JuliaCJ/FlexType-EMG-Keyboard/README.md

Thank you for ckecking out the FlexType EMG Keyboard! Due to privacy laws, we cannot share our gesture dataset on GitHub.

To see our product in action, check out our video demo [here](https://youtu.be/fAkPNovlsvg).
