JuliaCJ/FlexType-EMG-Keyboard/Documentation/Project Proposal/Customer Interview Plan.docx

Customer Interview Plan

Assumptions:

1. The user has some or most upper arm/ wrist muscle function
2. The user cannot perform fine/ delicate motor functions
3. The user needs to perform tasks that require typing
4. The user wants privacy when communicating
5. The user desires autonomy for typing related tasks

Interview Questions (For Disabled Users):

- What is your experience typing on traditional computer and mobile keyboards?
- What alternative to traditional keyboards do you use, if any?
- Have you ever asked anybody for help with typing-related tasks, ex. sending a text?
- What qualities do you look for in keyboards?
- What types of hand/ wrist/ arm movement are easiest for disabled people? Hardest?
- What struggles do you have when operating traditional keyboards?
- What struggles do you have when operating alternative keyboards, ex. Voice to text?

Interview Questions (For Caretakers):

- What is your experience helping patients type on traditional computers and mobile keyboards?
- What alternative to traditional keyboards do you usually recommend, if any?
- Have you ever been tasked with performing typing related tasks for patients?
- What qualities of traditional keyboards are hurtful for disabled patients?
- What types of hand/ wrist/ arm movement are easiest for disabled people? Hardest?
- What struggles do you see your patients encounter when they operate traditional keyboards?
- What struggles do you see your patients encounter when they operate alternative keyboards?

Contact List:

Jalen:

- Lourdes, Caretaker
- Leslie, Caretaker
- Dennis, Veteran
- Dexter, Disabled
- Tila, Caretaker

Giancarlos:

- Alejandro, Disabled
- Nydia, Therapist
- Wilfredo, Caretaker
- Renjith, Caretaker
- Faye, Caretaker

Julia:

- Barry, Disabled
- Brien, Caretaker
- Fanta, Caretaker
- Shawn, Caretaker
- Alma, Caretaker

Kejon:

- Ernest, Caretaker
- Garyah Fumbah, Caretaker
- Tola, Caretaker
- Sarai, Caretaker
- David, Disabled

Industry Experts:

- Dr. Coskus Tekes
- Dylan Gaines
