JuliaCJ/FlexType-EMG-Keyboard/Documentation/Project Design/Milestone 3 Presentation and Demo.pptx

## FlexType EMG Keyboard


Half-Byte Solutions

Julia Johnson
Giancarlos Hernandez Mendoza
Jalen Tottress
Kejon IverY

## Project Introduction

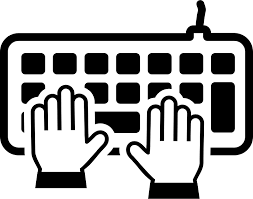
[picture p68: figure]
Typing Icon SVG Vector & PNG Free ...

- Problem Statement
  - A lot of people in the digital era uses a cellphone, laptop, or tablet daily to conduct daily activities. Yet for those who may not be able to do the same due to lack of fine muscle movement, there is nothing on the current market for this group of people. With that being said, what if there was a product to bridge the gap between fine motor limitation and digital autonomy.

- Our Solution
  - An electromyography keyboard that does not depend on fine motor movements
- Intended Users & Applications
  - Those who have limited fine motor control and want autonomy when engaging with the digital world

## Market Research

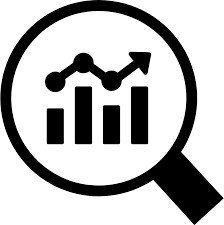
[picture p69: figure]
Market Research Analysis Icon SVG Vector & PNG Free Download | UXWing

- Target Users
  - Individuals with limited fine motor control
  - People who have difficulty using standard keyboards
- Existing Solutions
  - Voice-to-text
  - Wearable EMG devices (Meta Wristband)
  - Assistive input devices (Eye Tracking)
- Gaps
  - Voice inputs can lack privacy and reliability in noisy environments
  - Existing solutions can have steep learning curve, be expensive, or are too heavy to carry around

- How We're Different
  - The FlexType EMG Keyboard utilizes the user's muscle signals via a range of gestures to type words, with the help of a word prediction model
  - Designed with low-effort movements to support our target audience.
  - We are more private and discreet than voice-based systems
  - Cheaper than most existing solutions

## Product Requirements

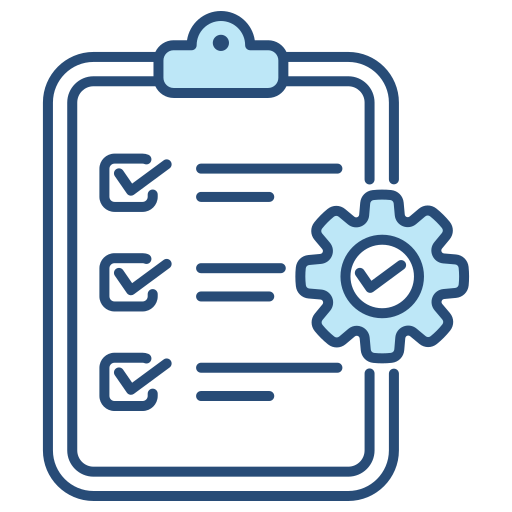
[picture p70: figure]
Requirement - Free files and folders icons

- Top Functional Requirements
  - EMG Wristband shall operate in low-power mode when not actively used
  - EMG wristband that converts analog EMG signal to digital
  - Wearable Device that transmits data
- Key Performance Targets
  - Gesture classification of 90% accuracy and above
  - Word Prediction of 90% accuracy and above
  - The EMG Wristband shall "wakeup" within 5 seconds of activation gesture

- Constraints & Assumptions
  - An economic constraint would be which EMG sensor to use, we opted to use 2-channel instead of 8 since the cost would be significantly cheaper
  - Gathering EMG data was entirely dependent on the schedule of those who volunteered and the availability of the lab
  - The product needs to be lightweight enough for the target audience to maneuver around and use the wristband as intended
  - The system's temperature operational range shall be 0°C to 50°C.

## System Design Overview: Hardware Subsystem

Electrode Board

Screw-type Electrodes

INA333
Instrumentation amp

OPA2320
Signal conditioning

Control Board

MCP3464R ADC

STM32C071 MCU
SPI -> USB bridge

FFC

USB

Raspberry Pi

Gesture Model

Word Prediction Model

## System Design Overview: Software Subsystem

Process Data

8 Channels

60Hz Notch Filter

20 – 80 Hz Bandpass Filter

250ms Window Size

Gesture Recognition Model

TensorFlow Framework

3 Layer, 1D CNN

8 Gestures + Rest

Driver

Word Prediction Model

N-gram Model

Runs on remote server

Generates the 3 most likely words

Predicts Gestures using live data

Converts Gestures into commands and coordinates

Calls Word Prediction Model API

Displays Predicted Word/Message

## Hardware Prototype: PCB Design

Control Board PCB

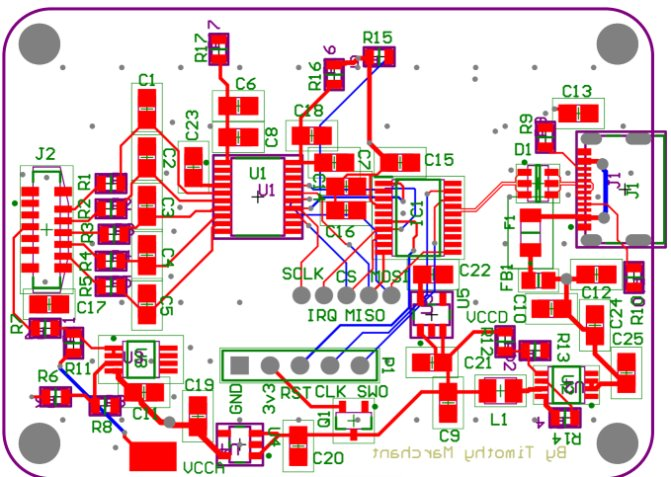
[picture p71: figure]

Control Board PCB

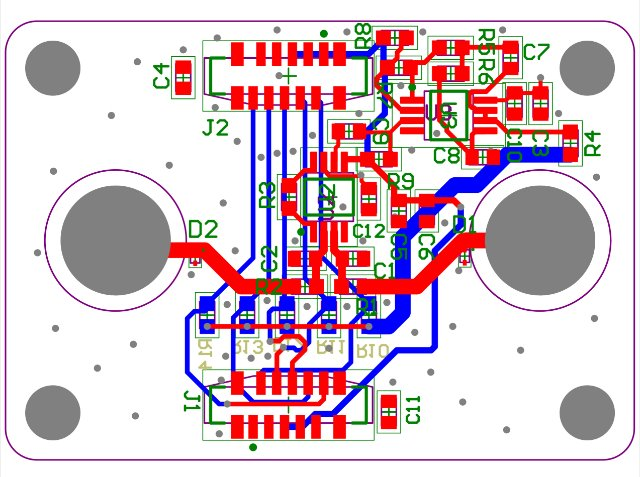
[picture p72: figure]

## Hardware Prototype: 3D Enclosure

Control Board 3D Model

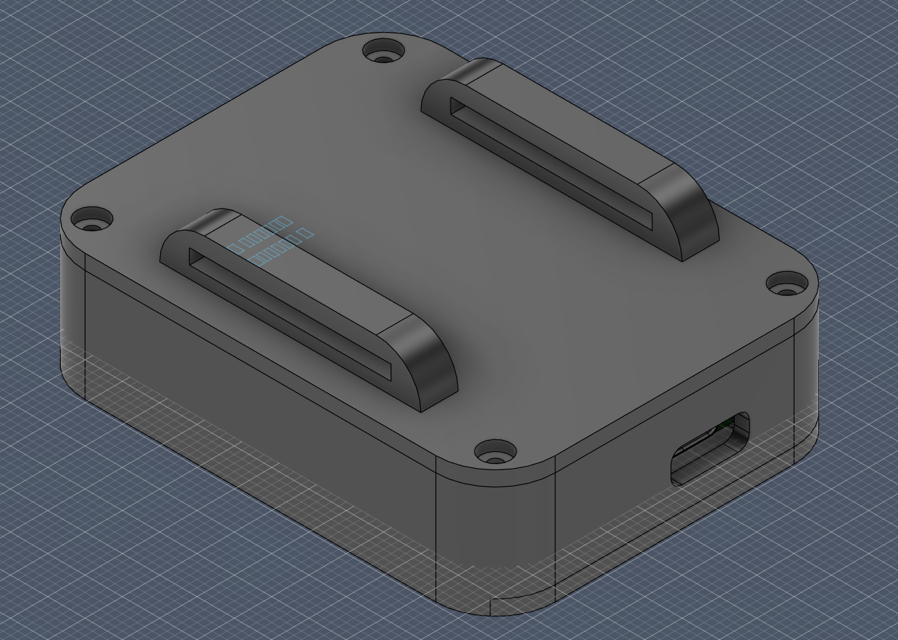
[picture p73: figure]

Control Board 3D Model

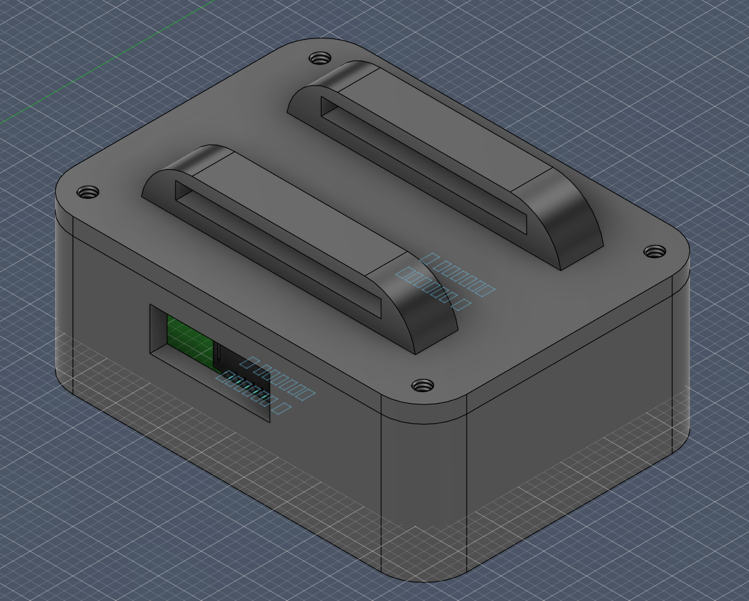
[picture p74: figure]

## Hardware Prototype: Hardware Images

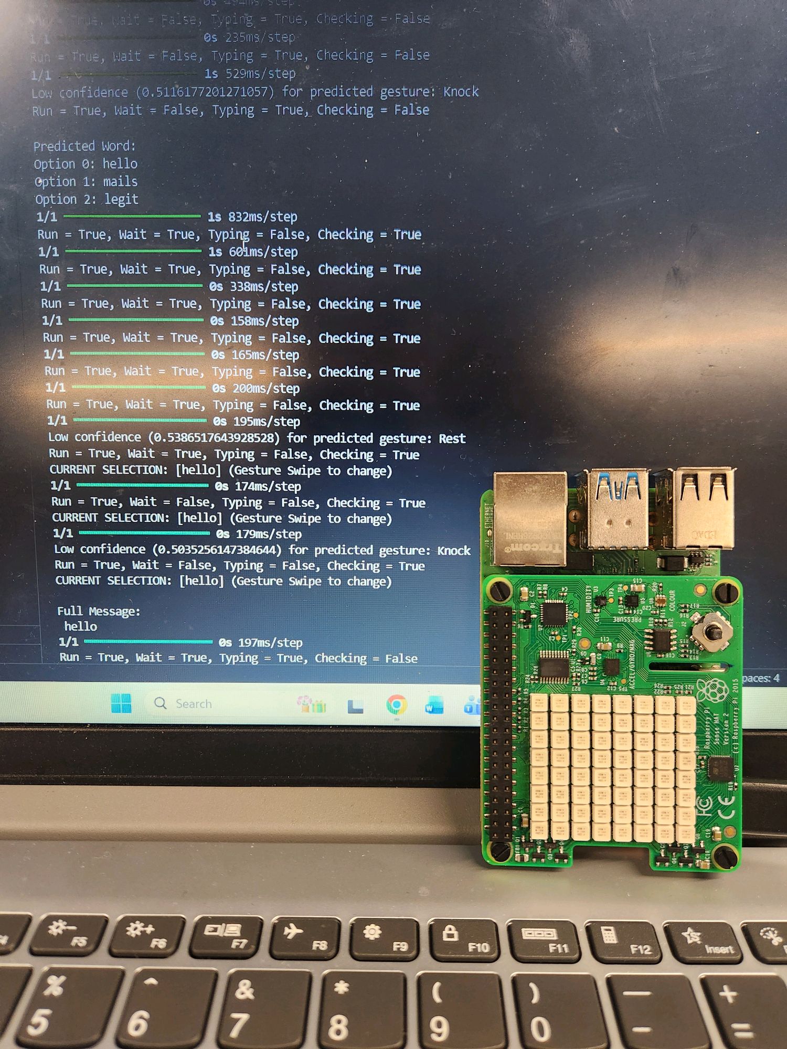
[picture p75: figure]
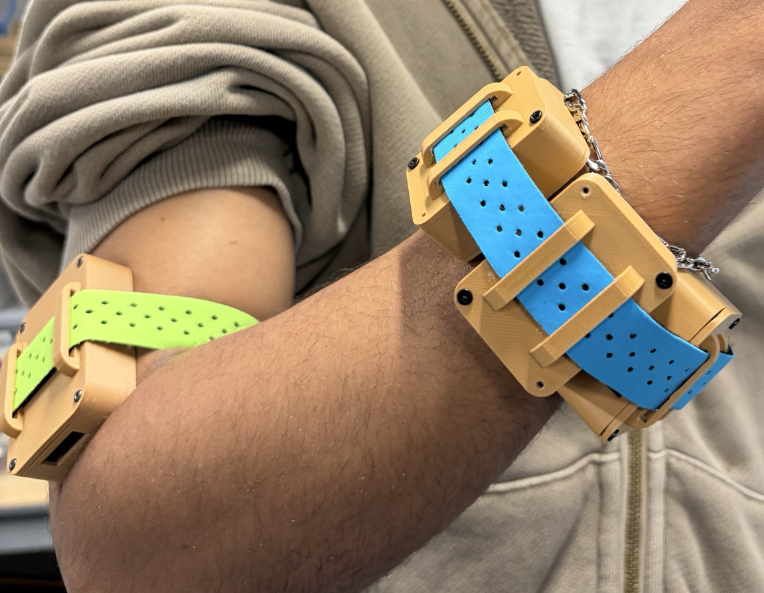
[picture p76: figure]
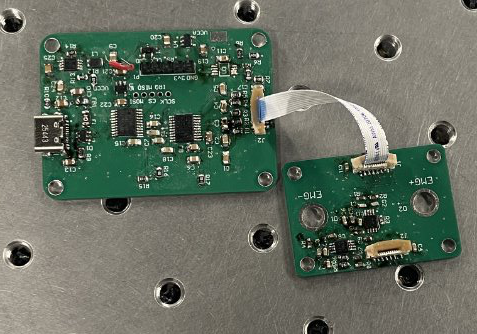
[picture p77: figure]

Control Board

Electrode Board

Control Board

## Software and Algorithm: Gesture Prediction Model

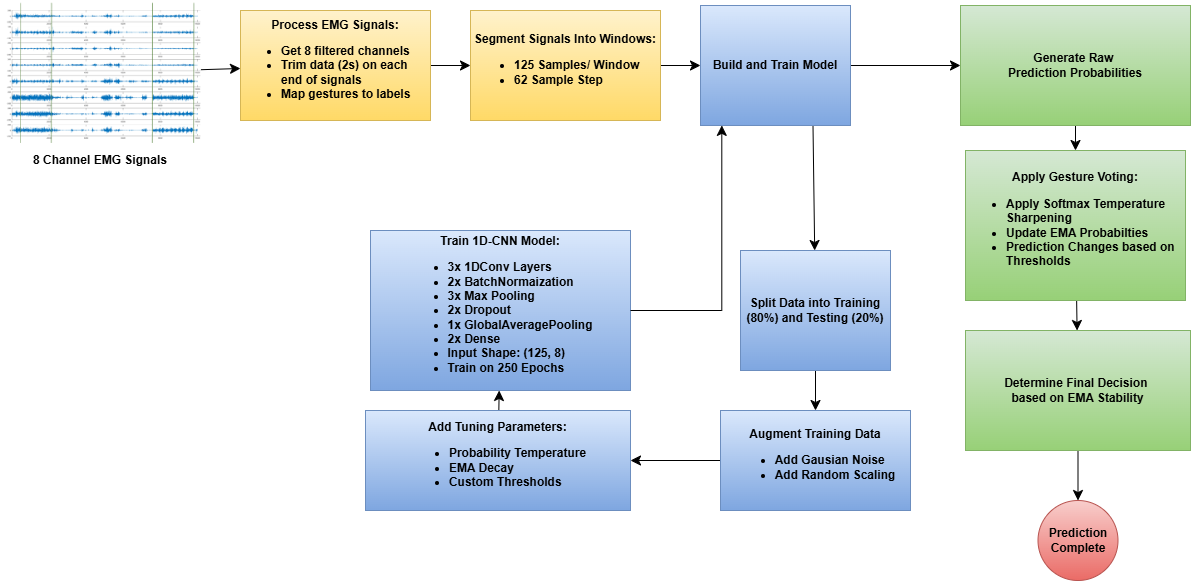
[picture p78: figure]

Notes: This figure shows the steps for training our model and generating 1 gesture prediction.

First, 8 channels of EMG data are gathered from the EMG armband. We then pull the data from the filtered channels, trim the 2 seconds of rest from each end of the active gesture signal, and map each gesture to a lab (Ex. Gesture 3 -> Middle Pinch).

Then, we segment the signals into windows, with 125 samples/ window and a sample step of 62. This breaks the long streams of data into smaller, more manageable pieces for training.

To build the model, we first split the data into 80% training and 20% testing. Because we lacked volunteers to gather data from, we also augment the data to give the illusion of more samples. To augment the data, we add gausian noise and random scaling to mimic different signal strengths. Because some gestures are stronger than others, we also tune the prediction algorithm to better predict weaker gestures. We use Exponential Moving Average (EMA) to help average prediction weights, probability temperature to control control prediction sensitivity, and custom thresholds to boost weak predictions and weaken strong ones that are over-predicted.

Lastly, we build a 3 layer 1D-CNN model with the shown attributes. The model is trained over 250 epochs.

Once the model has trained, we can make a prediction on passed in gestures. To make each prediction, a raw probability score is generated first. Then, the model moves to voting. It applies Softmax Temperature Sharpening to increase prediction confidence, update EMA probabilities, and determine the prediction based on whether or not certain custom thresholds are met.

Final, the final gesture prediction is made based on overall EMA stability.

## Software and Algorithm: Gesture Prediction Model

Confusion Matrix

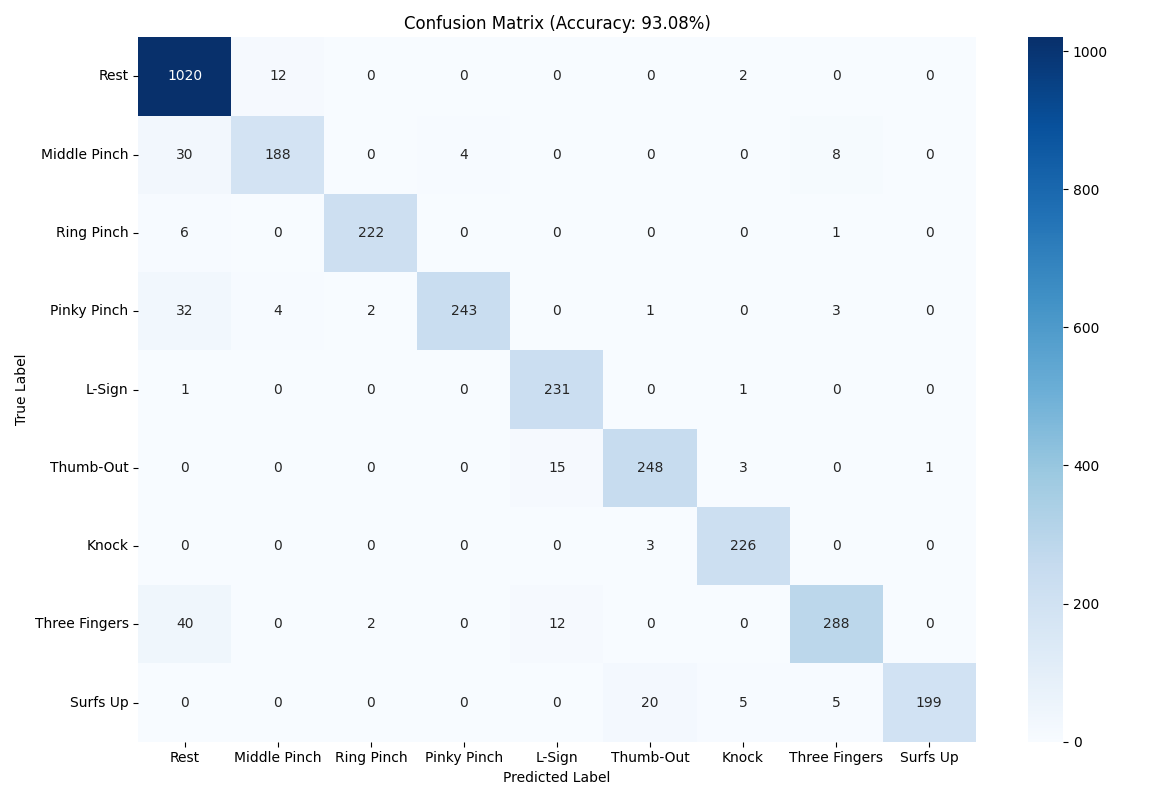
[picture p80: figure]

Gesture Commands & Accuracies

Gesture | Command | Prediction Accuracy
Rest | - | 98.65%
Middle Pinch | A-F | 81.74%
Ring Pinch | G-M | 96.94%
Pinky Pinch | M-T | 85.26%
Three Fingers | U-Z | 84.21%
L-Sign | Swipe | 99.14%
Thumb-Out | Delete | 92.88%
Knock | Space/ Enter | 98.69%
Surfs Up | Start/ Stop | 86.90%
| Overall: | 93.08%

Notes: The results shown are based on new, unseen data taken from a different day/ time from the data the model was trained on. As you can see, the model does a good job of differentiating between each gesture. The most common confusions are with Middle Pinch (Confused with Rest), Pinky Pinch (Weaker so confused with Rest) and Thumb-Out (confused with Surfs Up because similar).

The lowest performing gesture is the Middle Pinch, which is ~82% accurate. The highest performing gesture is Knock, which is 98.69% accurate. Overall, the system is ~93% accurate, which met our goal of at least 90% accuracy.

## Software and Algorithm: Driver Algorithm

State Diagram

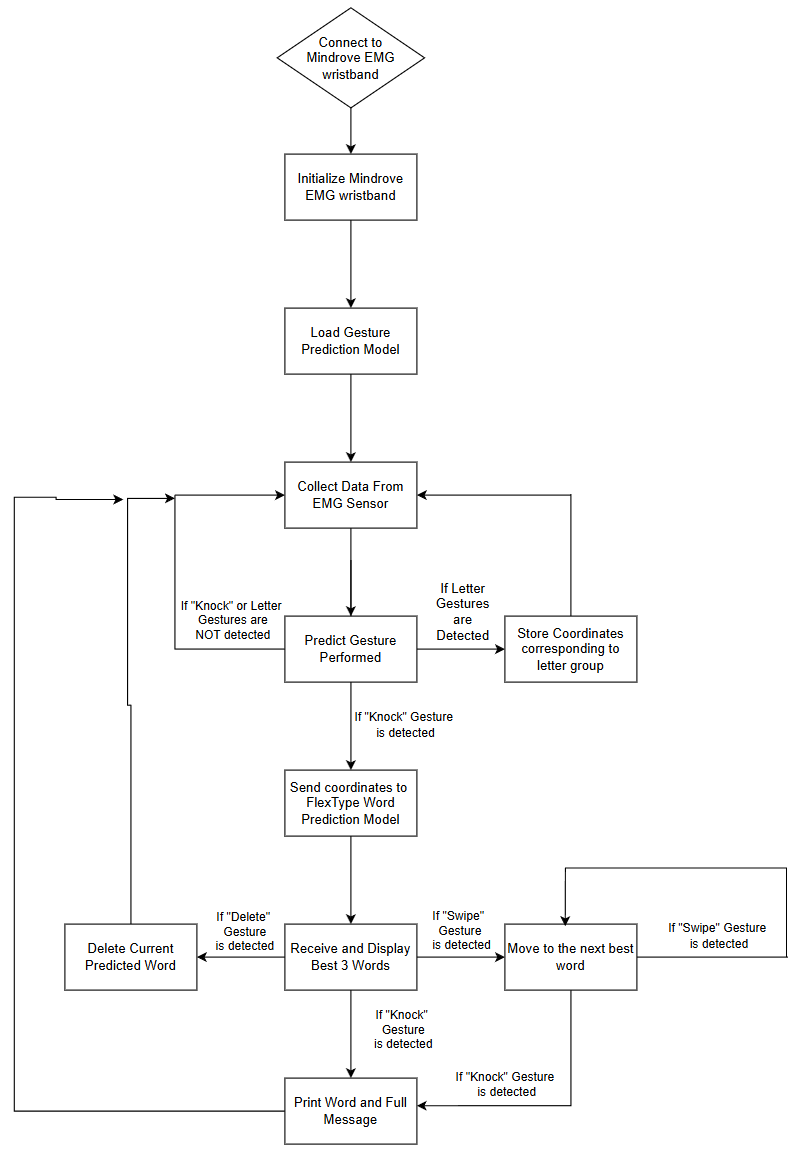
[picture p81: figure]

Screenshots from Typing

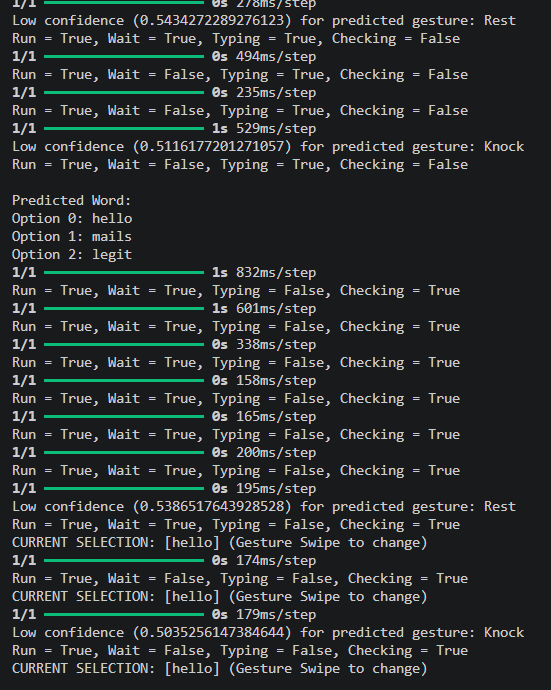
[picture p82: figure]

## Live Demo

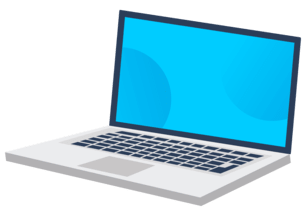
[picture p83: figure]
A Laptop Clipart PNG, Vector, PSD, and Clipart With Transparent Background for Free Download | Pngtree

## Remaining Work Before Expo

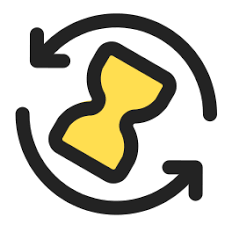
[picture p84: figure]
Download Free Progress Icons in PNG & SVG

- Software Remaining Work
  - Fix FlexType API call on Raspberry Pi
  - Validate Test Cases
    - "Wake" Typing, Type "Hello" Successfully, End Typing
    - Type "I am happy" Successfully
      - Validate "Swipe" and "Delete" Functions during "happy"
    - Type "I like birds" Successfully
  - Adjust gesture prediction rate to be smoother/ faster
  - Clean up terminal output to be less crowded and more user friendly

- Hardware Remaining Work
  - Continue testing the two PCBs to see how accurate the signal we are getting from them are.
  - Implement the software models with our PCBs to test their accuracy
- Expo Preparation
  - Make Video Demo
