JuliaCJ/FlexType-EMG-Keyboard/Documentation/Project Design/Milestone Goals.docx

CPE 4850 Senior Project Design, Spring 2026

Project Milestone Goals

Date: _January 12, 2026_

PURPOSE: Effective project planning and regular progress tracking are essential to the success of any projects. The three milestone dates serve as checkpoints to demonstrate meaningful, measurable progress and to ensure the project stays on track.

At each milestone, list the team’s top goals and deliverables, and break down each goal into specific subgoals that describe the detailed tasks, steps, or intermediate outcomes needed to achieve it. While the primary focus should remain on team goals, you may also note individual responsibilities that support these goals. This ensures accountability and highlights how each member contributes to the overall success of the project.

# MILESTONE #1: Week 6 (February 18)

1. Design and order PCB (Hardware Team)
  a. Design PCB in EDA software
  b. Draft PCB casing in 3D printing software
  c. Order PCB board
  d. Ensure PCB is integration ready
2. Configure word prediction model on Raspberry Pi (Hardware Team)
  a. Research and understand word prediction model
  b. Download word prediction model on Raspberry Pi
  c. Update input format in word prediction model
3. Research and plan gesture recognition algorithm (Software Team)
  a. Research existing gesture recognition algorithms
  b. Determine which model or combination of models would be optimal to use
  c. Determine how letter groups and commands should be divided among gestures
4. Create initial model training set (Software Team)
  a. Make list of potential volunteers
  b. Prepare and share consent forms for volunteers
  c. Secure regular access to EMG device
  d. Define 10-12 possible gestures
  e. Collect gesture EMG data from at least 12 volunteers with commercial EMG
  f. Compile EMG data into one dataset as a .csv file or folder(s) of .csv files

# MILESTONE #2: Week 11 (March 25)

1. Combine hardware components (Hardware Team)
  a. PCB arrives
  b. Verify PCB functionality
  c. 3D print casing for PCB
  d. Combine PCB with casing
2. Gesture model recognizes at least 4 gestures (Software Team)
a. Start building the neural network that will serve as our gesture recognition AI model
b. Identify which gestures are easy and difficult to recognize
c. Train the AI model using collected data and achieve at least 90% accuracy on at least 4 gestures
3. Refine model training set (Software Team)
  a. Gather EMG data from at least 18 more individuals (dataset should contain samples from 30+ individuals)
  b. Determine final 8-10 gestures
  c. Remove un-needed gestures from the dataset
  d. Begin gathering training data with PCB instead of commercial EMG
4. Update word prediction model to recognize gestures as letters (Software Team)
a. Determine what the gesture recognition model will output when detecting a gesture.
b. Increase the number of different inputs the word prediction model can receive
c. Determine and update the letters corresponding to each input of the word prediction model
d. Begin integrating both AI models so that the word prediction model can recognize an output from the gesture recognition model as a valid input

# MILESTONE #3: Week 15 (April 22)

1. Complete software and hardware integration (Hardware Team)
  a. PCB is fully functional and integrated with both gesture and word model
  b. PCB is able to function with no software errors
  c. PCB can be worn without risk of hardware damage or personal injury
  d. Word prediction output can be displayed on laptop via SSH or dedicated display window
2. Device achieves 90% typing accuracy (Full Team)
a. Expand the gesture recognition AI model to be able to recognize 8 to 10 gestures with at least 90% accuracy.
b. Test that the word prediction model can accept the outputs of the AI recognition model as functional and valid inputs.
c. Test that the word prediction model outputs the desired word at least 90% of the time
d. Perform successful tests with 5 new/ untrained users
3. Finalize model training set (Software Team)
  a. Model training set contains data from 50+ individuals
  b. All new data is gathered with final PCB (no longer using commercial EMG)
  c. Remove any outlier samples to ensure training set is optimized
4. Make project presentation and demo (Full Team)
  a. Make poster presentation
  b. Record video demonstration
  c. Practice live demonstration

Reviewed and agreed by:

Team Name: Half-Byte Solutions

Team members: Julia Johnson, Giancarlos Hernandez, Jalen Tottress, Kejon Ivery

Instructor: ________________ (Prof. Jeffrey L Yiin)

CPE 4850 Senior Project Design
