JuliaCJ/FlexType-EMG-Keyboard/Hardware Files/ElectrodeBoard.step

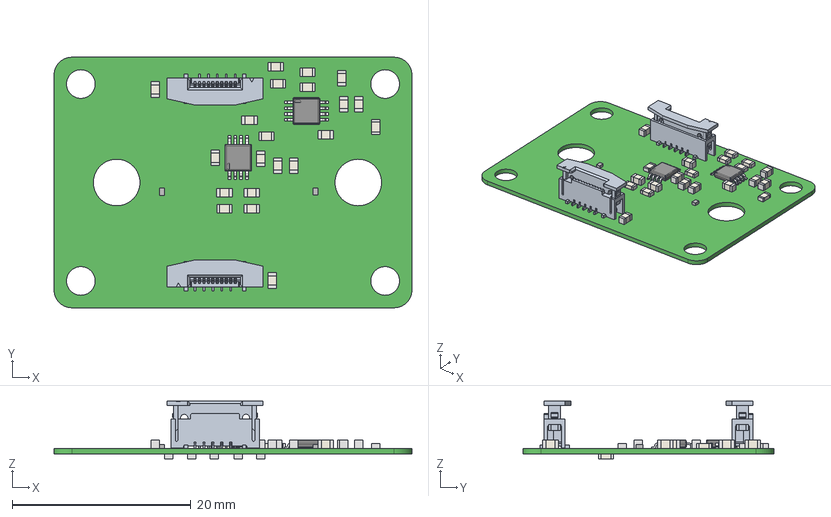
[picture p114: CAD file, 2026-05-10]
Hardware Files/ElectrodeBoard.step
40.0 x 28.0 x 6.47 mm
Extruded x 80
BODY_MUY08A x 2
LEAD_MUY08A x 16
EXP_PAD_MUY08A x 2
