JuliaCJ/FlexType-EMG-Keyboard/Hardware Files/ControlBoard.step

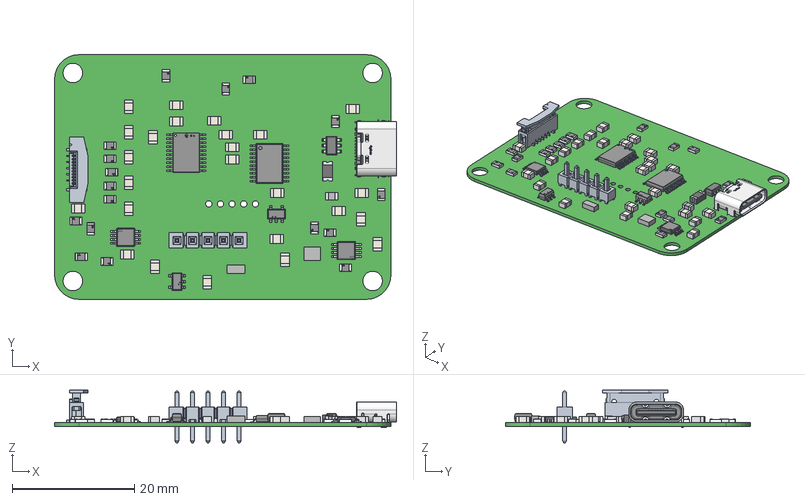
[picture p115: CAD file, 2026-05-10]
Hardware Files/ControlBoard.step
55.9 x 40.0 x 8.60 mm
solidIntersect
Terminal
term1
term2
Extruded x 77
BODY-SOT x 2
LEAD-SOT x 10
Texas Logo Yury x 2
Texas Logo Yury - Copy x 2
terminals x 17
logo x 17
top x 17
BODY_MUY08A x 2
LEAD_MUY08A x 16
EXP_PAD_MUY08A x 2
Leader x 6
TSW-105-05-X-S
PinsArrayLR
Pins
0.35mm
Microchip Logo
Notch
Molex
