JuliaCJ/FlexType-EMG-Keyboard/(list of files, cad)

Other CAD files:
Hardware Files/ControlBoard.stl
Hardware Files/ElectrodeBoard.stl
