JuliaCJ/FlexType-EMG-Keyboard/Results/conf_matrix.png

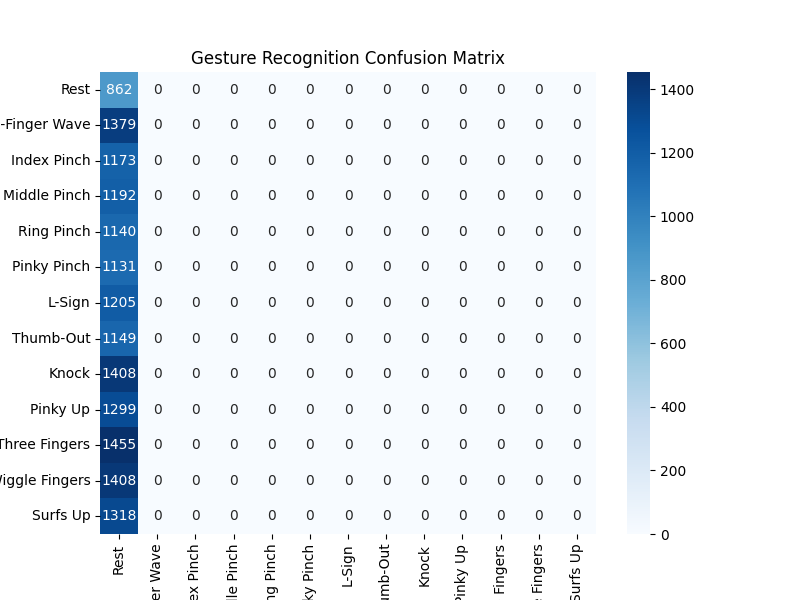
Results/conf_matrix.png
