JuliaCJ/FlexType-EMG-Keyboard/Results/gesture_rms_plots.png

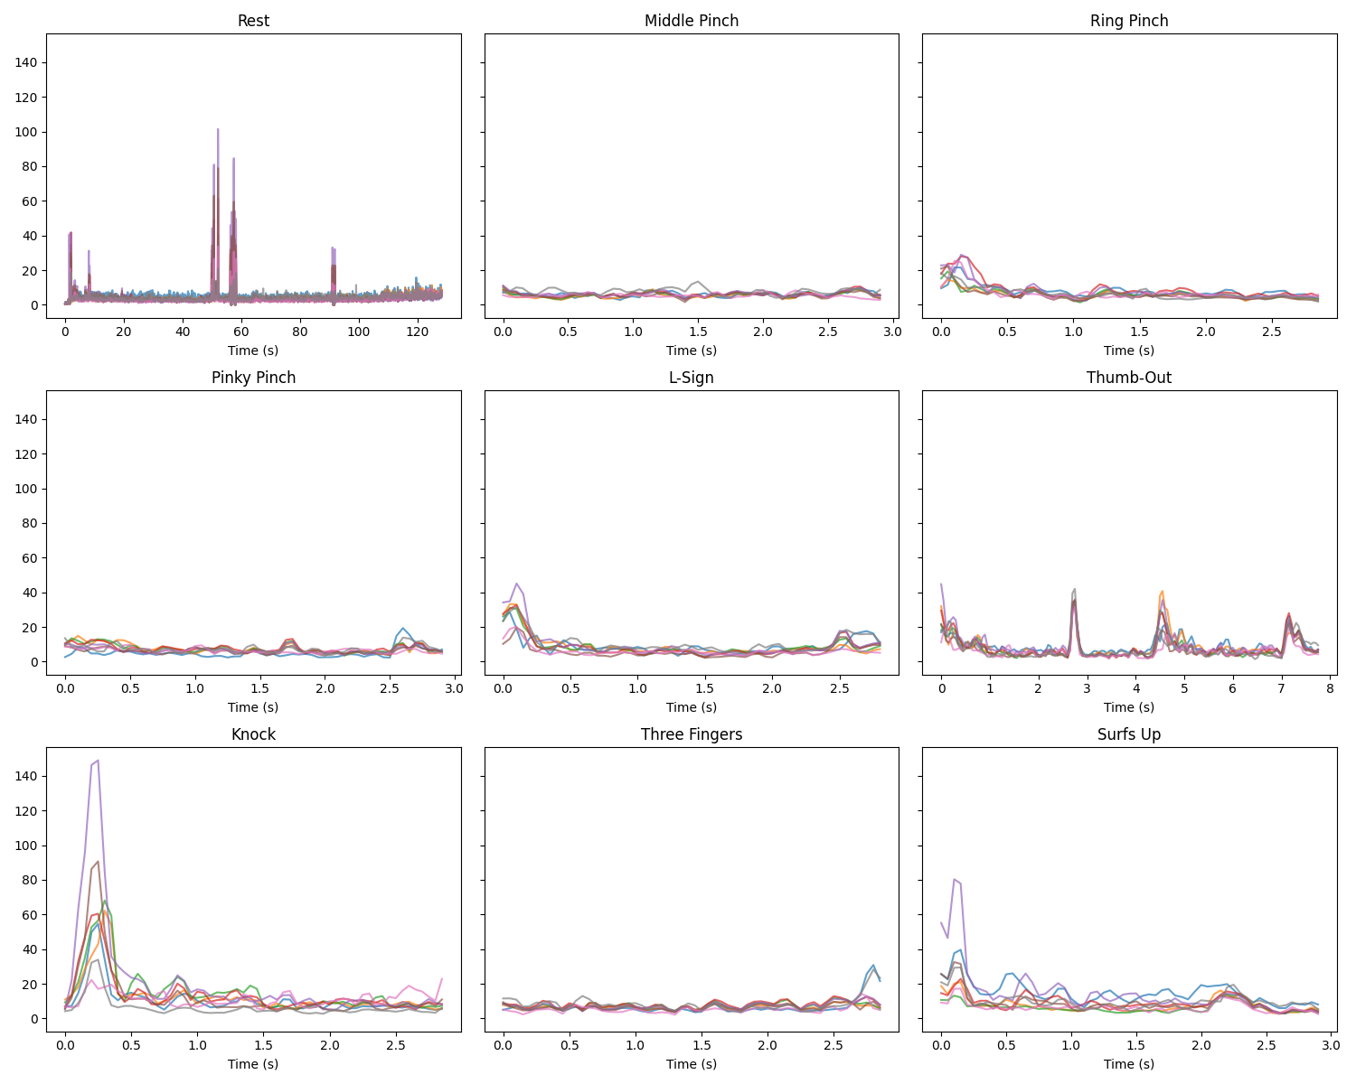
Results/gesture_rms_plots.png
