JuliaCJ/FlexType-EMG-Keyboard/Results/model_acc.png

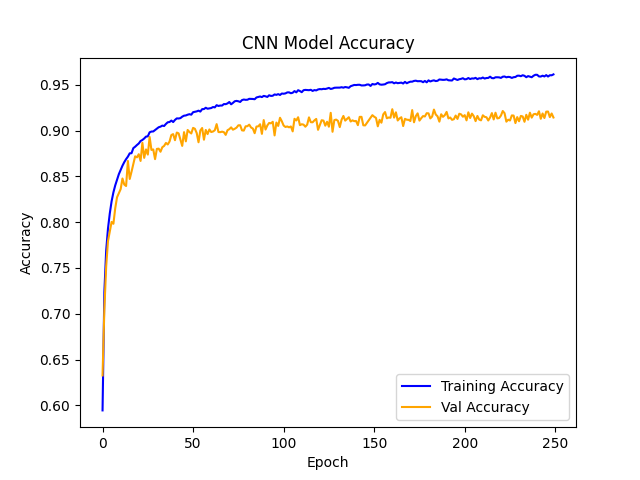
Results/model_acc.png
