JuliaCJ/FlexType-EMG-Keyboard/Results/model_loss.png

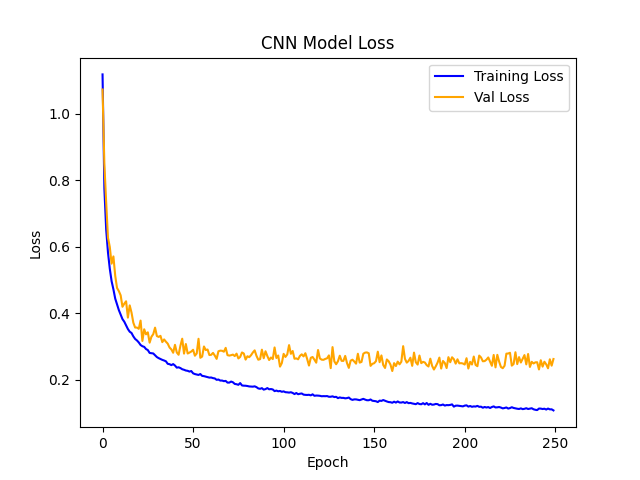
Results/model_loss.png
