JuliaCJ/FlexType-EMG-Keyboard/Results/test_conf_matrix.png

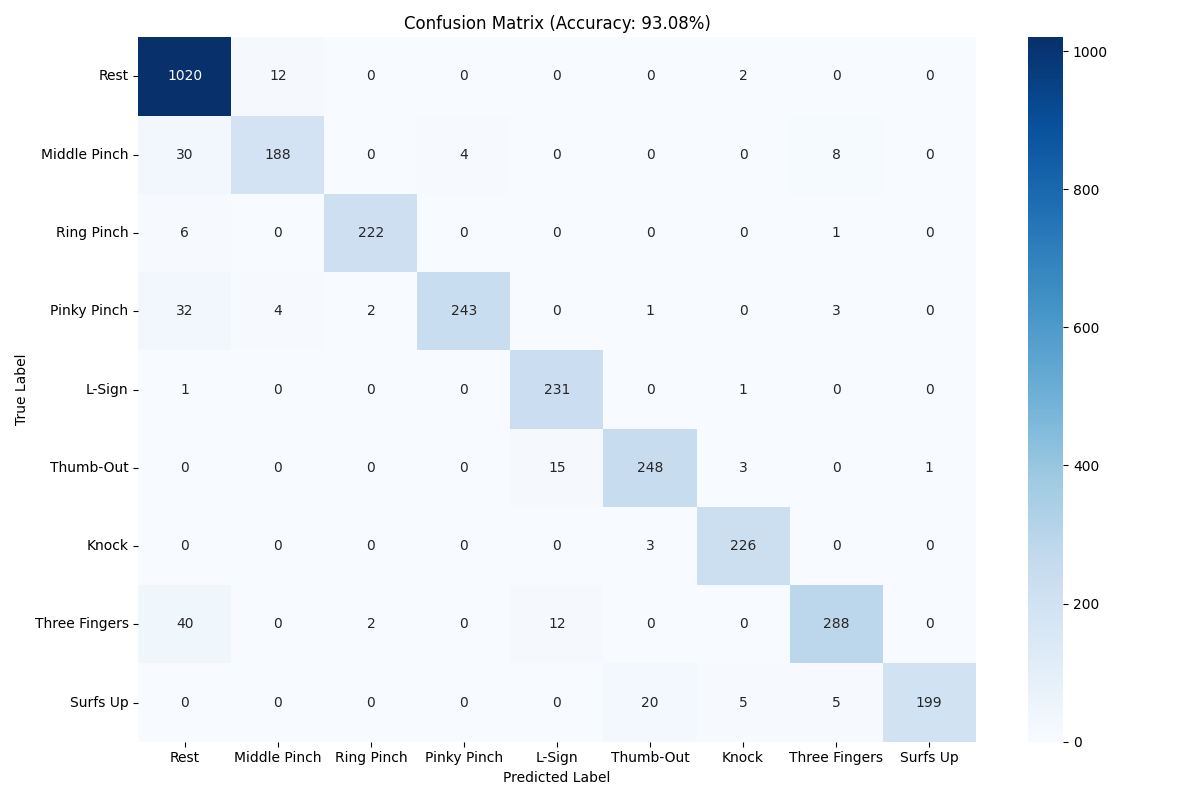
Results/test_conf_matrix.png
