JuliaCJ/FlexType-EMG-Keyboard/(commit log)

2026-04-06 Add gesture data
    [L-sign-1.csv, L-sign-10.csv, L-sign-2.csv, L-sign-3.csv, L-sign-4.csv, L-sign-5.csv, L-sign-6.csv, L-sign-7.csv]
2026-04-06 Adding gesture data
    [L-sign-1.csv, L-sign-10.csv, L-sign-2.csv, L-sign-3.csv, L-sign-4.csv, L-sign-5.csv, L-sign-6.csv, L-sign-7.csv]
